bikerglen/usb-analog-panel-meters/README.md

# usb-analog-panel-meters

See https://bikerglen.com/blog/building-usb-analog-panel-meters/ for a description of the boards and software available in this repository.
