bikerglen/usb-analog-panel-meters/boards/four-meters-usb-c-bom.xlsx

Qty | Parts | Description | Mfr | Mfr Part # | Dist | Dist Part #
11 | C1, C2, C3, C4, C5, C6, C7, C8, C9, C11, C12 | CAP CER 0.1UF 50V X7R 0603 | KEMET | C0603C104K5RACTU | Digi-Key | 399-5089-1-ND
2 | C10, C13 | CAP CER 1UF 16V X7R 0603 | KEMET | C0603C105K4RACTU | Digi-Key | 399-7847-1-ND
1 | C15 | CAP CER 1UF 25V X7R 1210 | KEMET | C1210C105K3RACTU | Digi-Key | 399-8220-1-ND
8 | D1, D2, D3, D4, D5, D6, D7, D8 | DIODE GEN PURP 100V 150MA SOD123 | Micro Commercial Co | 1N4148W-TP | Digi-Key | 1N4148WTPMSCT-ND
2 | J1, J2 | TERM BLK 4POS SIDE ENT 3.5MM PCB | Phoenix Contact | 1751264 | Digi-Key | 277-5744-ND
1 | J3 | TERM BLK 10P SIDE ENT 2.54MM PCB | On Shore Technology Inc. | OSTVN10A150 | Digi-Key | ED10567-ND
1 | J4 | CONN RCPT USB2.0 TYPEC 5A | GCT | USB4105-GF-A | Digi-Key | 2073-USB4105-GF-ACT-ND
4 | Q1, Q2, Q3, Q4 | TRANS NPN 300V 0.5A TO225AA | ON Semiconductor | MJE340G | Digi-Key | MJE340GOS-ND
8 | Q5, Q6, Q7, Q8, Q9, Q10, Q11, Q12 | TRANS NPN 50V 2A SOT23-3 | Diodes Incorporated | FMMT619TA | Digi-Key | FMMT619CT-ND
4 | R1, R2, R3, R4 | RES SMD 402 OHM 1% 1/2W 1210 | Vishay Dale | CRCW1210402RFKEA | Digi-Key | 541-402AACT-ND
9 | R8, R9, R10, R12, R14, R15, R16, R18, R20 | RES SMD 1K OHM 5% 1/10W 0603 | Panasonic Electronic Components | ERJ-3GEYJ102V | Digi-Key | P1.0KGCT-ND
3 | R5, R6, R7 | RES SMD 4.7K OHM 5% 1/10W 0603 | Panasonic Electronic Components | ERJ-3GEYJ472V | Digi-Key | P4.7KGCT-ND
2 | R11, R13 | RES SMD 10K OHM 5% 1/10W 0603 | Panasonic Electronic Components | ERJ-3GEYJ103V | Digi-Key | P10KGCT-ND
2 | R22, R23 | RES SMD 5.1K OHM 5% 1/10W 0603 | Panasonic Electronic Components | ERJ-3GEYJ512V | Digi-Key | P5.1KGCT-ND
1 | U1 | IC TRNSLTR BIDIRECTIONAL 24TSSOP | Texas Instruments | SN74LVC8T245PW | Digi-Key | 296-34079-5-ND
2 | U2, U3 | IC DAC 8BIT V-OUT 8SOIC | Texas Instruments | TLV5626CD | Digi-Key | 296-2311-5-ND
4 | U4, U5, U6, U7 | IC OPAMP GP 1 CIRCUIT SOT23-5 | Texas Instruments | OPA344NA/3K | Digi-Key | 296-41475-1-ND
1 | U8 | IC LED DRVR LIN DIM 25MA 28TSSOP | NXP USA Inc. | PCA9685PW,118 | Digi-Key | 568-11925-1-ND
1 | U9 | TVS DIODE 5.5V SOT143B | Nexperia USA Inc. | PRTR5V0U2X,215 | Digi-Key | 1727-3884-1-ND
1 | U10 | IC MCU 8BIT 16KB FLASH 24QSOP | Silicon Labs | EFM8UB11F16G-C-QSOP24 | Digi-Key | 336-3411-5-ND
1 | D1 | LED GREEN CLEAR CHIP SMD | Kingbright | APHCM2012CGCK-F01 | Digi-Key | 754-1094-1-ND
4 | --- | HUA SO45 10mA Panel Meter | HUA | --- | eBay/AliExpress | ---
 |  |  |  |  |  |  | Texas Instruments
 |  |  |  |  |  |  | Texas Instruments
 |  |  |  |  |  |  | Texas Instruments
 |  |  |  |  |  |  |  | NXP
 |  |  |  |  |  |  |  | Silicon Labs
