bikerglen/usb-analog-panel-meters/boards/four-meters-usb-c-three-page.brd

## EAGLE design boards/four-meters-usb-c-three-page.brd (2020-11-02)

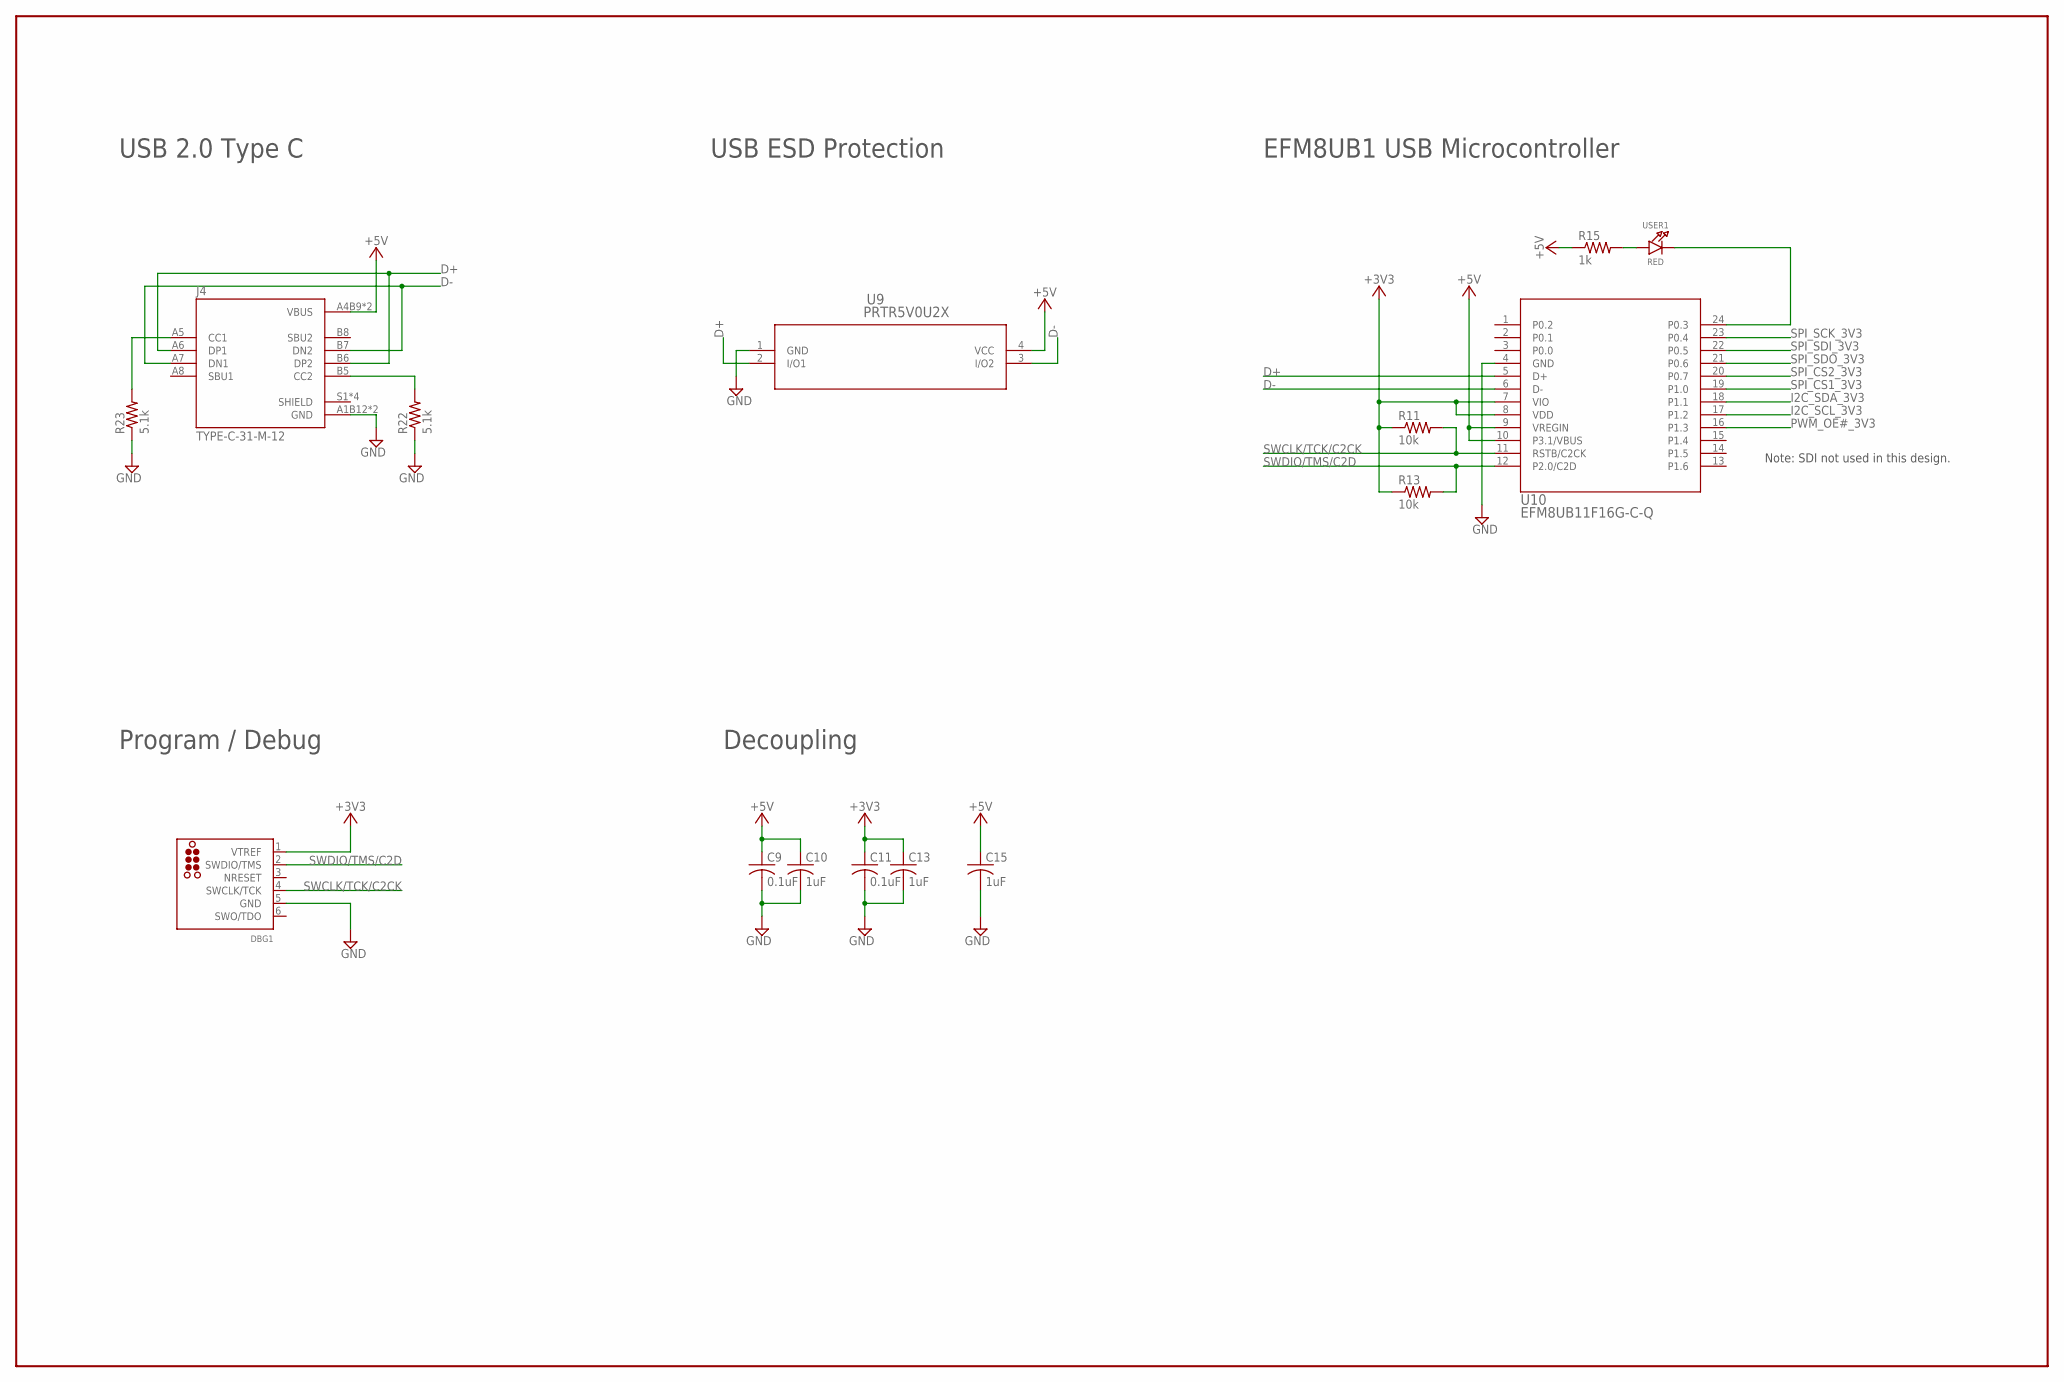
[picture p1: schematic four-meters-usb-c-three-page.sch, sheet 1]

Parts:
C9, C11: 0.1uF; C0603
C10, C13: 1uF; C0603
C15: 1uF; C1210K
DBG1: TC2030-CTX-SWD; TC2030-MCP-NL
J4: TYPE-C-31-M-12; HRO_TYPE-C-31-M-12
R11, R13: 10k; R0603
R15: 1k; R0603
R22, R23: 5.1k; R0603
U9: PRTR5V0U2X; SOT143B
U10: EFM8UB11F16G-C-Q; QSOP24
USER1: RED; CHIPLED_0805_NOOUTLINE

Connections:
+3V3: C11.1, C13.1, DBG1.1 (VTREF), R11.1, R13.1, U10.7 (VIO), U10.8 (VDD); also elsewhere on the board
+5V: C9.1, C10.1, C15.1, J4.A4B9 (VBUS), J4.B4A9 (VBUS), R15.1, U9.4 (VCC), U10.9 (VREGIN), U10.10 (P3.1/VBUS); also elsewhere on the board
D+: J4.A6 (DP1), J4.B6 (DP2), U9.2 (I/O1), U10.5 (D+)
D-: J4.A7 (DN1), J4.B7 (DN2), U9.3 (I/O2), U10.6 (D-)
GND: C9.2, C10.2, C11.2, C13.2, C15.2, DBG1.5 (GND), J4.A1B12 (GND), J4.B1A12 (GND), R22.1, R23.1, U9.1 (GND), U10.4 (GND); also elsewhere on the board
I2C_SCL_3V3: U10.17 (P1.2); also elsewhere on the board
I2C_SDA_3V3: U10.18 (P1.1); also elsewhere on the board
LED1: U10.24 (P0.3), USER1.C
unnamed: R15.2, USER1.A
unnamed: J4.B5 (CC2), R22.2
unnamed: J4.A5 (CC1), R23.2
NRESET: DBG1.3 (NRESET)
PWM_OE#_3V3: U10.16 (P1.3); also elsewhere on the board
SPI_CS1_3V3: U10.19 (P1.0); also elsewhere on the board
SPI_CS2_3V3: U10.20 (P0.7); also elsewhere on the board
SPI_SCK_3V3: U10.23 (P0.4); also elsewhere on the board
SPI_SDI_3V3: U10.22 (P0.5)
SPI_SDO_3V3: U10.21 (P0.6); also elsewhere on the board
SWCLK/TCK/C2CK: DBG1.4 (SWCLK/TCK), R11.2, U10.11 (RSTB/C2CK)
SWDIO/TMS/C2D: DBG1.2 (SWDIO/TMS), R13.2, U10.12 (P2.0/C2D)

Notes on the sheet:
USB 2.0 Type C
USB ESD Protection
EFM8UB1 USB Microcontroller
Program / Debug
Decoupling
Note: SDI not used in this design.

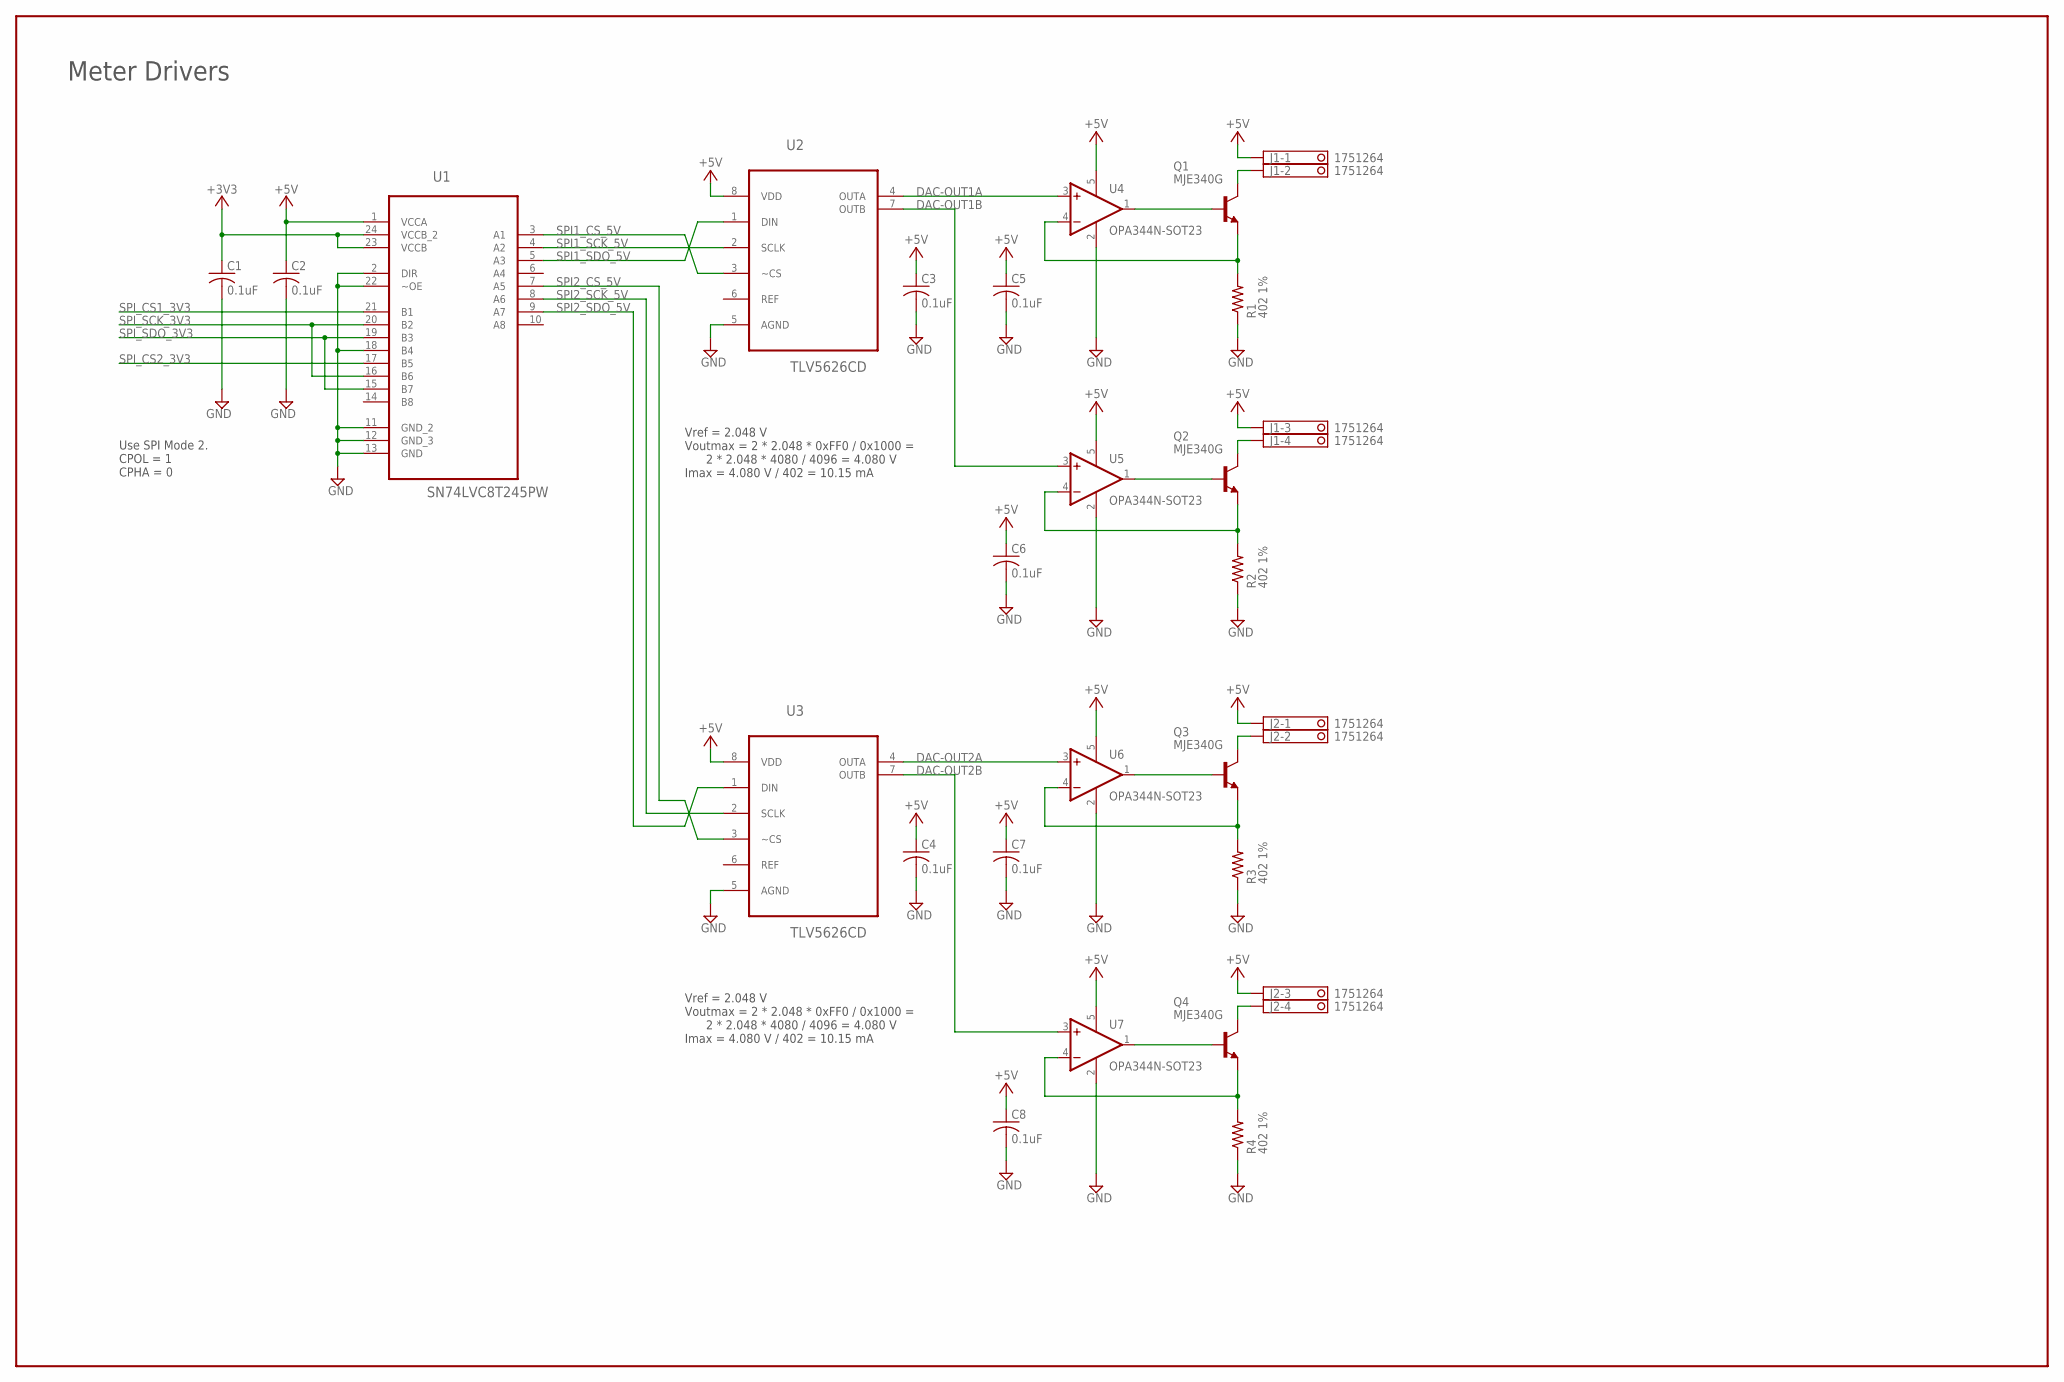
[picture p2: schematic four-meters-usb-c-three-page.sch, sheet 2]

Parts:
C1, C2, C3, C4, C5, C6, C7, C8: 0.1uF; C0603K; MFR_PART_NO C1206C104K5RACAUTO
J1, J2: 1751264
Q1, Q2, Q3, Q4: MJE340G; TO126V; MFR_PART_NO MJE340G
R1, R2, R3, R4: 402 1%; R1210; MFR_PART_NO ERJ-14NF73R2U
U1: SN74LVC8T245PW; SOP65P640X120-24N; MFR_PART_NO SN74LVC8T245PW
U2, U3: TLV5626CD; SOIC127P600X175-8N; MFR_PART_NO TLV5626CD
U4, U5, U6, U7: OPA344N-SOT23; SOT23-5; MFR_PART_NO OPA344NA/3K

Connections:
+3V3: C1.1, U1.23 (VCCB), U1.24 (VCCB_2); also elsewhere on the board
+5V: C2.1, C3.1, C4.1, C5.1, C6.1, C7.1, C8.1, J1.1, J1.3, J2.1, J2.3, U1.1 (VCCA), U2.8 (VDD), U3.8 (VDD), U4.5 (V+), U5.5 (V+), U6.5 (V+), U7.5 (V+); also elsewhere on the board
DAC-OUT1A: U2.4 (OUTA), U4.3 (+IN)
DAC-OUT1B: U2.7 (OUTB), U5.3 (+IN)
DAC-OUT2A: U3.4 (OUTA), U6.3 (+IN)
DAC-OUT2B: U3.7 (OUTB), U7.3 (+IN)
GND: C1.2, C2.2, C3.2, C4.2, C5.2, C6.2, C7.2, C8.2, R1.1, R2.1, R3.1, R4.1, U1.2 (DIR), U1.11 (GND_2), U1.12 (GND_3), U1.13 (GND), U1.18 (B4), U1.22 (~OE), U2.5 (AGND), U3.5 (AGND), U4.2 (V-), U5.2 (V-), U6.2 (V-), U7.2 (V-); also elsewhere on the board
unnamed: Q1.1 (E), R1.2, U4.4 (-IN)
unnamed: Q3.1 (E), R3.2, U6.4 (-IN)
unnamed: Q1.3 (B), U4.1 (OUT)
unnamed: Q3.3 (B), U6.1 (OUT)
unnamed: Q4.1 (E), R4.2, U7.4 (-IN)
unnamed: Q4.3 (B), U7.1 (OUT)
unnamed: Q2.1 (E), R2.2, U5.4 (-IN)
unnamed: Q2.3 (B), U5.1 (OUT)
OUT1A: J1.2, Q1.2 (C)
OUT1B: J1.4, Q2.2 (C)
OUT2A: J2.2, Q3.2 (C)
OUT2B: J2.4, Q4.2 (C)
SPI1_CS_5V: U1.3 (A1), U2.3 (~CS)
SPI1_SCK_5V: U1.4 (A2), U2.2 (SCLK)
SPI1_SDO_5V: U1.5 (A3), U2.1 (DIN)
SPI2_CS_5V: U1.7 (A5), U3.3 (~CS)
SPI2_SCK_5V: U1.8 (A6), U3.2 (SCLK)
SPI2_SDO_5V: U1.9 (A7), U3.1 (DIN)
SPI_CS1_3V3: U1.21 (B1); also elsewhere on the board
SPI_CS2_3V3: U1.17 (B5); also elsewhere on the board
SPI_SCK_3V3: U1.16 (B6), U1.20 (B2); also elsewhere on the board
SPI_SDO_3V3: U1.15 (B7), U1.19 (B3); also elsewhere on the board

Notes on the sheet:
Vref = 2.048 V Voutmax = 2 * 2.048 * 0xFF0 / 0x1000 = 2 * 2.048 * 4080 / 4096 = 4.080 V Imax = 4.080 V / 402 = 10.15 mA
Use SPI Mode 2. CPOL = 1 CPHA = 0
Meter Drivers

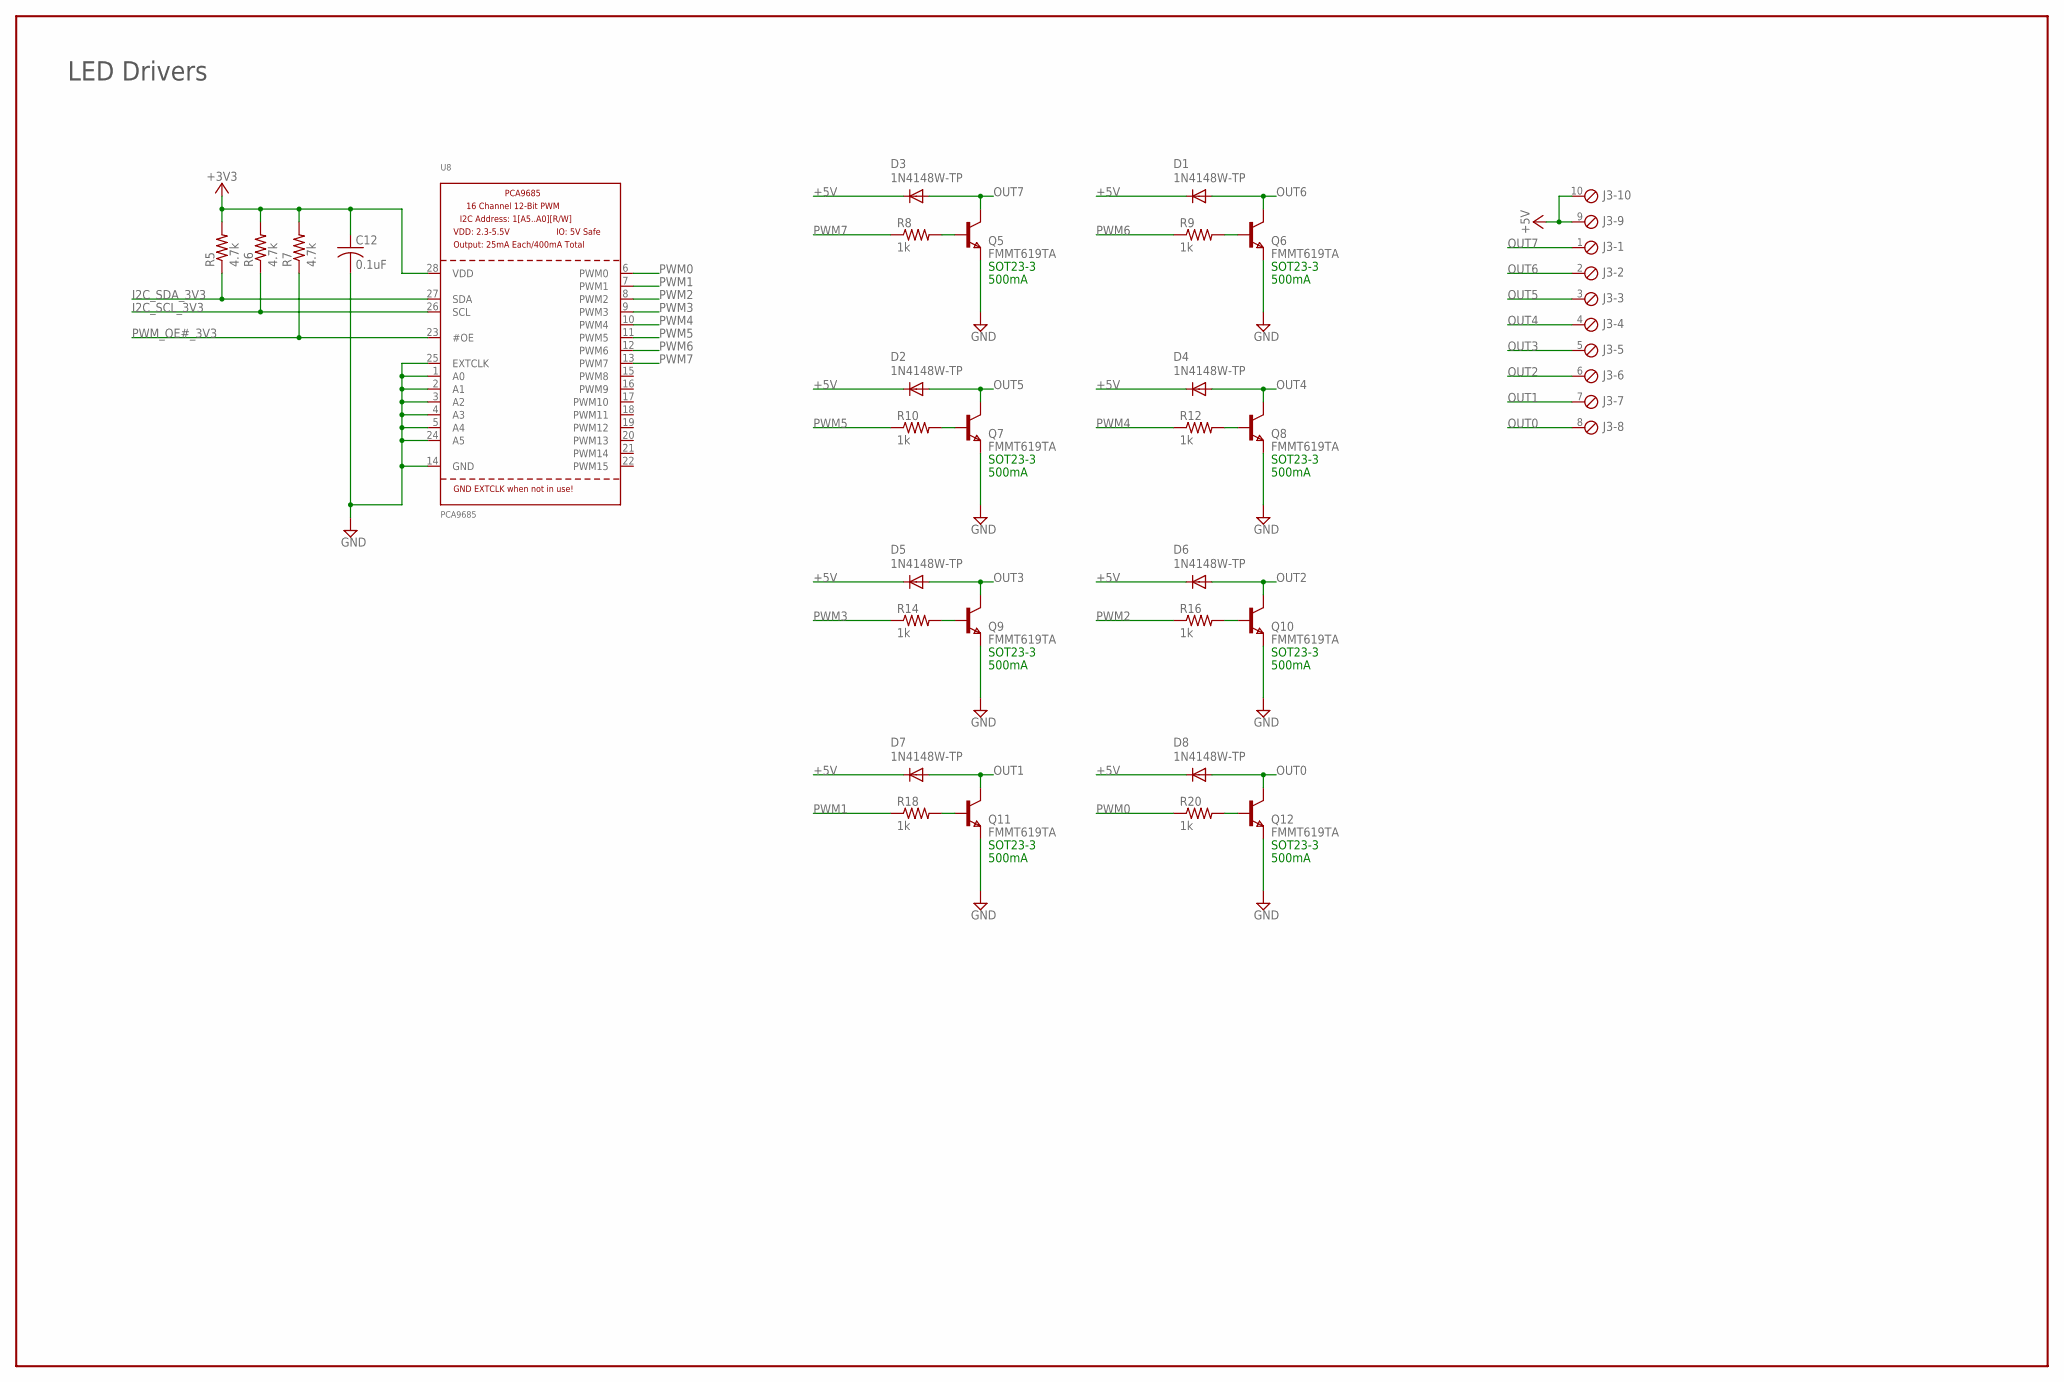
[picture p3: schematic four-meters-usb-c-three-page.sch, sheet 3]

Parts:
C12: 0.1uF; C0603K; MFR_PART_NO C1206C104K5RACAUTO
D1, D2, D3, D4, D5, D6, D7, D8: 1N4148W-TP; SOD123
J3: MPT10; 10POL254
Q5, Q6, Q7, Q8, Q9, Q10, Q11, Q12: FMMT619TA; SOT-23
R5, R6, R7: 4.7k; R0603
R8, R9, R10, R12, R14, R16, R18, R20: 1k; R0603
U8: PCA9685; TSSOP28

Connections:
+3V3: C12.1, R5.2, R6.2, R7.2, U8.28 (VDD); also elsewhere on the board
+5V: D1.C, D2.C, D3.C, D4.C, D5.C, D6.C, D7.C, D8.C, J3.9, J3.10; also elsewhere on the board
GND: C12.2, Q5.2 (E), Q6.2 (E), Q7.2 (E), Q8.2 (E), Q9.2 (E), Q10.2 (E), Q11.2 (E), Q12.2 (E), U8.1 (A0), U8.2 (A1), U8.3 (A2), U8.4 (A3), U8.5 (A4), U8.14 (GND), U8.24 (A5), U8.25 (EXTCLK); also elsewhere on the board
I2C_SCL_3V3: R6.1, U8.26 (SCL); also elsewhere on the board
I2C_SDA_3V3: R5.1, U8.27 (SDA); also elsewhere on the board
unnamed: Q6.3 (B), R9.2
unnamed: Q7.3 (B), R10.2
unnamed: Q8.3 (B), R12.2
unnamed: Q9.3 (B), R14.2
unnamed: Q10.3 (B), R16.2
unnamed: Q11.3 (B), R18.2
unnamed: Q12.3 (B), R20.2
unnamed: Q5.3 (B), R8.2
OUT0: D8.A, J3.8, Q12.1 (C)
OUT1: D7.A, J3.7, Q11.1 (C)
OUT2: D6.A, J3.6, Q10.1 (C)
OUT3: D5.A, J3.5, Q9.1 (C)
OUT4: D4.A, J3.4, Q8.1 (C)
OUT5: D2.A, J3.3, Q7.1 (C)
OUT6: D1.A, J3.2, Q6.1 (C)
OUT7: D3.A, J3.1, Q5.1 (C)
PWM0: R20.1, U8.6 (PWM0)
PWM1: R18.1, U8.7 (PWM1)
PWM2: R16.1, U8.8 (PWM2)
PWM3: R14.1, U8.9 (PWM3)
PWM4: R12.1, U8.10 (PWM4)
PWM5: R10.1, U8.11 (PWM5)
PWM6: R9.1, U8.12 (PWM6)
PWM7: R8.1, U8.13 (PWM7)
PWM_OE#_3V3: R7.1, U8.23 (#OE); also elsewhere on the board

Notes on the sheet:
SOT23-3
500mA
LED Drivers

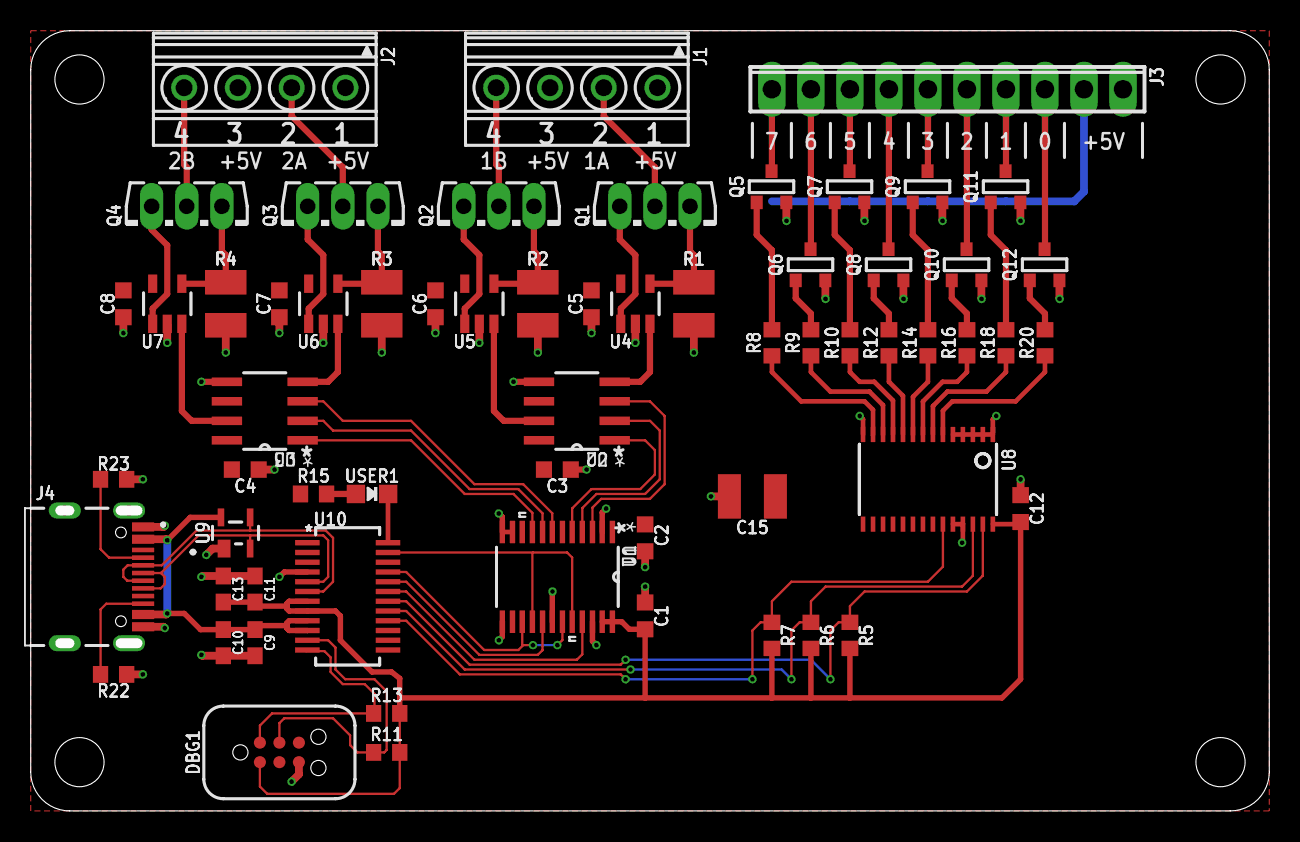
[picture p4: board four-meters-usb-c-three-page.brd from above]

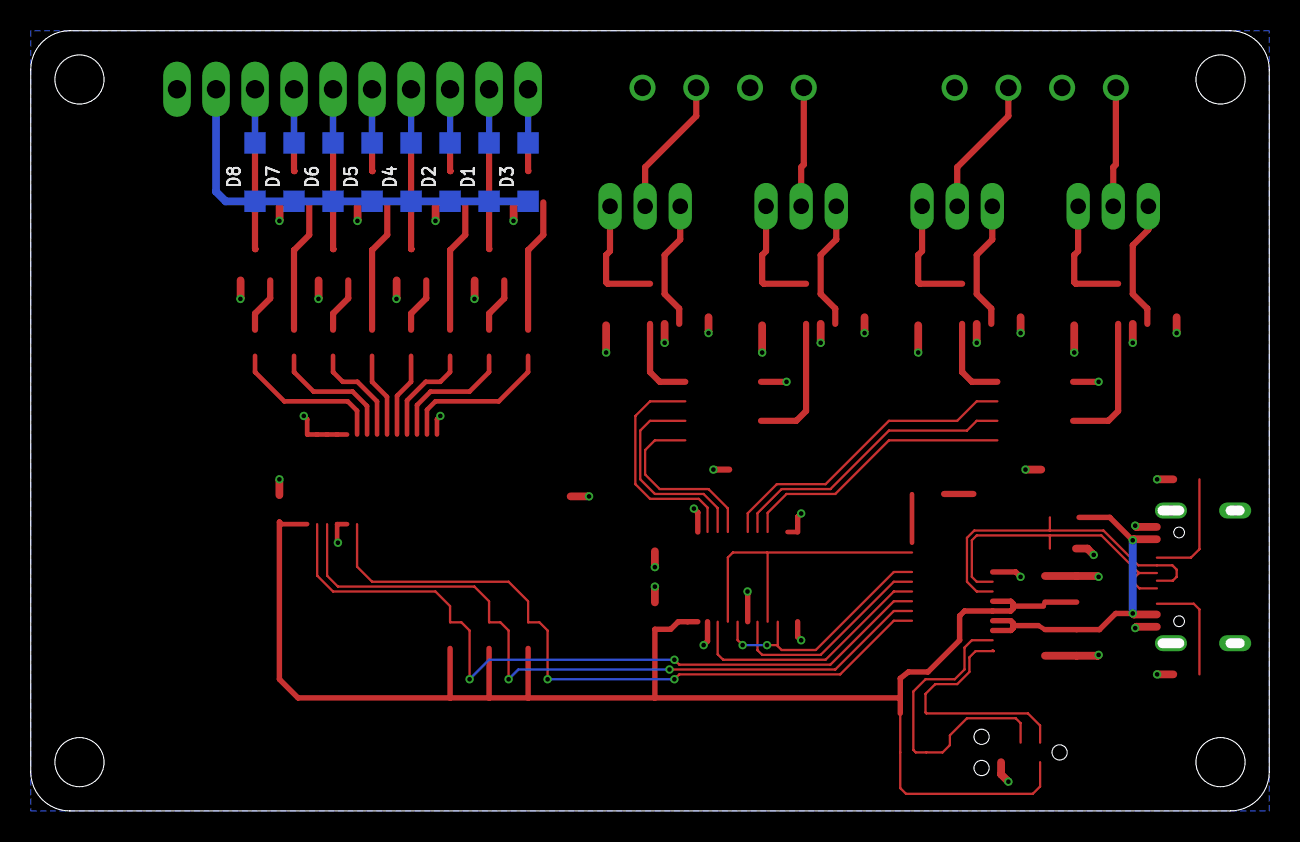
[picture p5: board four-meters-usb-c-three-page.brd from below]

Board: 2 copper layers, 80.6 x 50.8 mm, 70 parts (8 on the bottom side), 64 nets.
