bikerglen/usb-analog-panel-meters/(commit log)

2020-11-02 initial checkin
    [four-meters-usb-c-bom.xlsx, four-meters-usb-c-three-page.brd, four-meters-usb-c-three-page.sch]
2020-11-03 added 34461A lxi/scpi current measurement code
